charithjp/Precharger/README.md

# Precharger

This project will be a simple DC bus precharger for a 60V DC bus, controlled by an Arduino Nano. Detailed specs to follow.
