charithjp/Precharger/Precharger-KiCAD/BOM/Precharger.xlsx

Source: | C:\git\Precharger\Precharger-KiCAD\Precharger.sch
Date: | 2019-12-08 16:40
Tool: | Eeschema (5.1.2)-2
Generator: | C:\Program Files\KiCad\bin\scripting\plugins/bom_csv_grouped_by_value_with_fp.py
Component Count: | 61
Ref | Qnty | Value | Cmp name | Digikey PN | Order Description | Order QTY | Order Lines | Description | Footprint | Vendor
A1, | 1 | Arduino_Nano_v3.x | Arduino_Nano_v3.x | 1050-ABX00028-ND | Arduino Nano Every | 1 | 1,1050-ABX00028-ND,Arduino Nano Every | Arduino Nano v3.x | Module:Arduino_Nano
C2, C1, | 2 | 2.2uF 100V | C | 478-12481-1-ND | 5V input capacitor | 10 | 10,478-12481-1-ND,5V input capacitor | 2.2µF ±10% 100V Ceramic Capacitor X7R 1206 (3216 Metric) | Capacitor_SMD:C_1210_3225Metric_Pad1.42x2.65mm_HandSolder
C3, C4, | 2 | 10uF | C | 1276-6455-1-ND | 10uF 16V 0805 MLCC | 10 | 10,1276-6455-1-ND,10uF 16V 0805 MLCC | 10µF ±10% 16V Ceramic Capacitor X5R 0805 (2012 Metric) | Capacitor_SMD:C_0805_2012Metric_Pad1.15x1.40mm_HandSolder
C5, C6, | 2 | 100nF | C | 1276-2450-1-ND | 100nF 50V 0805 MLCC | 10 | 10,1276-2450-1-ND,100nF 50V 0805 MLCC | 0.1µF ±20% 50V Ceramic Capacitor X7R 0805 (2012 Metric) | Capacitor_SMD:C_0805_2012Metric_Pad1.15x1.40mm_HandSolder
C7, | 1 | 22uF | C | 399-16572-ND | 12V input capacitor | 2 | 2,399-16572-ND,12V input capacitor | 22µF 100V Aluminum Polymer Capacitor Radial, Can 45mOhm 2000 Hrs @ 125°C | Capacitor_THT:CP_Radial_D10.0mm_P5.00mm
D1, | 1 | ASMB-MTB1-0A3A2 | ASMB-MTB1-0A3A2 | 516-3280-1-ND | RGB LED | 2 | 2,516-3280-1-ND,RGB LED | Red, Green, Blue (RGB) 625nm Red, 530nm Green, 470nm Blue LED Indication - Discrete 2.1V Red, 3.1V Green, 3.1V Blue 4-PLCC | LED_SMD:LED_Avago_PLCC4_3.2x2.8mm_CW
F1, | 1 | Polyfuse | Polyfuse | 507-1349-ND | 5V input fuse | 2 | 2,507-1349-ND,5V input fuse | Polymeric PTC Resettable Fuse 240V 80mA Ih Through Hole Radial, Disc | Fuse:Fuse_BelFuse_0ZRE0008FF_L8.3mm_W3.8mm
F2, | 1 | Fuse | Fuse | 486-1173-ND | Fuseholder Clip | 4 | 4,486-1173-ND,Fuseholder Clip | Fuse Clip 10A 1 Circuit Cartridge Through Hole | General_Library:Fuseholder_Clip-5x20mm_Schurter_0751_0052_Horizontal_Open
 |  |  |  | 486-2023-ND | Fuse cover | 2 | 2,486-2023-ND,Fuse cover | FUSEHOLDER COVER FOR 1.6W
 |  |  |  | 486-1820-ND | Fuse | 5 | 5,486-1820-ND,Fuse | 5A 250V AC 125V DC Fuse Cartridge, Ceramic Holder 5mm x 20mm
J1, | 1 | Screw_Terminal_01x04 | Screw_Terminal_01x04 | 609-4979-ND | 1x4 Wire to Board | 2 | 2,609-4979-ND,1x4 Wire to Board | 4 Position Wire to Board Terminal Block Horizontal with Board 0.138" (3.50mm) Through Hole | TerminalBlock_Phoenix:TerminalBlock_Phoenix_PT-1,5-4-3.5-H_1x04_P3.50mm_Horizontal
J2, J3, J5, | 3 | Anderson_PP45_Power_RA | Anderson_PP45_Power_RA | Not available at Digikey |  |  |  | Anderson Powerpole PP45 Power Connection - RA Bottom Row | Anderson_Powerpole:Anderson_Powerpole-45A-RA-Bottom-Pair
JP2, JP1, | 2 | SolderJumper_2_Open | SolderJumper_2_Open | N/A |  |  |  | Solder Jumper, 2-pole, open | Jumper:SolderJumper-2_P1.3mm_Open_RoundedPad1.0x1.5mm
JP4, JP3, JP8, JP7, JP6, JP5, JP9, JP10, | 8 | SolderJumper_2_Bridged | SolderJumper_2_Bridged | N/A |  |  |  | Solder Jumper, 2-pole, closed/bridged | Jumper:SolderJumper-2_P1.3mm_Bridged2Bar_RoundedPad1.0x1.5mm
L1, | 1 | 68uH | L | 587-2432-1-ND | 5V input filter inductor | 2 | 2,587-2432-1-ND,5V input filter inductor | 68µH Unshielded Wirewound Inductor 190mA 1Ohm 1210 (3225 Metric) | Inductor_SMD:L_1210_3225Metric_Pad1.42x2.65mm_HandSolder
M1, M2, M3, | 3 | Anderson_PP45_Staple_Nx2 | Anderson_PP45_Staple_Nx2 | Not available at Digikey |  |  |  |  | Anderson_Powerpole:Anderson_Powerpole-staple-Nx2
PS1, | 1 | Delta_E48SC12010NRFA | Delta_E48SC12010NRFA | 941-1766-ND | 12V DCDC | 1 | 1,941-1766-ND,12V DCDC | Isolated Module DC DC Converter 1 Output 12V 10A 36V - 75V Input
Q1, | 1 | SQJQ480E | SQJQ480E | SQJQ480E-T1_GE3CT-ND | Close switch | 2 | 2,SQJQ480E-T1_GE3CT-ND,Close switch | N-Channel 80V 150A (Tc) 136W (Tc) Surface Mount PowerPAK® 8 x 8
Q2, | 1 | BSS123 | BSS123 | BSS123LT1GOSCT-ND | 12V Ena FET | 5 | 5,BSS123LT1GOSCT-ND,12V Ena FET | N-Channel 100V 170mA (Ta) 225mW (Ta) Surface Mount SOT-23-3 (TO-236)
R2, R1, R5, R4, | 4 | 22M | R | RMCF0805FT22M0CT-ND | Divider R 22M | 10 | 10,RMCF0805FT22M0CT-ND,Divider R 22M | 22 MOhms ±1% 0.125W, 1/8W Chip Resistor 0805 (2012 Metric) Automotive AEC-Q200 Thick Film
R3, R6, | 2 | 3.3M | R | RMCF0805FT3M30CT-ND | Divider R 3.3M | 5 | 5,RMCF0805FT3M30CT-ND,Divider R 3.3M | 3.3 MOhms ±1% 0.125W, 1/8W Chip Resistor 0805 (2012 Metric) Automotive AEC-Q200 Thick Film
R8, R7, | 2 | 470R 5W | R | A131375CT-ND | Precharge resistor | 4 | 4,A131375CT-ND,Precharge resistor | 470 Ohms ±5% 5W Through Hole Resistor Axial Flame Retardant Coating, Pulse Withstanding, Safety Wirewound
R10, R9, | 2 | 330R | R | In Kit |  |  |  | Resistor | Resistor_SMD:R_0805_2012Metric_Pad1.15x1.40mm_HandSolder
R11, | 1 | 150R | R | In Kit |  |  |  | Resistor | Resistor_SMD:R_0805_2012Metric_Pad1.15x1.40mm_HandSolder
R12, R13, | 2 | 100R | R | In Kit |  |  |  | Resistor | Resistor_SMD:R_0805_2012Metric_Pad1.15x1.40mm_HandSolder
R14, R15, | 2 | TRIM_UP | R | N/A |  |  |  | Resistor | Resistor_SMD:R_0805_2012Metric_Pad1.15x1.40mm_HandSolder
TP4, TP3, TP2, TP1, TP6, TP7, TP8, TP5, | 8 | TestPoint | TestPoint | N/A |  |  |  | test point | TestPoint:TestPoint_Keystone_5010-5014_Multipurpose
U1, U2, | 2 | MCP6001-OT | MCP6001-OT | MCP6001T-I/OTCT-ND | Opamp | 10 | 10,MCP6001T-I/OTCT-ND,Opamp | General Purpose Amplifier 1 Circuit Rail-to-Rail SOT-23-5
U3, | 1 | R-78HE5.0-0.3 | R-78HB5.0-0.5 | 945-3461-ND | 5V DCDC | 2 | 2,945-3461-ND,5V DCDC | Non-Isolated PoL Module DC DC Converter 1 Output 5V 300mA 6.5V - 72V Input
U4, | 1 | CPC1004N | CPC1004N | CLA154-ND | Precharge Optorelay | 2 | 2,CLA154-ND,Precharge Optorelay | Solid State SPST-NO (1 Form A) 4-SOP (0.150", 3.81mm)
U5, | 1 | VOM1271 | VOM1271 | VOM1271TCT-ND | Close driver | 2 | 2,VOM1271TCT-ND,Close driver | Optoisolator Photovoltaic Output 4500Vrms 1 Channel 4-SOP (2.54mm)
U6, | 1 | ISO7321C | ISO7321C | 296-42102-1-ND | 1/1 Isolator | 2 | 2,296-42102-1-ND,1/1 Isolator | General Purpose Digital Isolator 3000Vrms 2 Channel 25Mbps 25kV/µs CMTI 8-SOIC (0.154", 3.90mm Width)
 |  |  |  |  |  |  |  |  | 0
