charithjp/Precharger/Precharger-v2-KiCAD/Precharger.kicad_pcb

## KiCad design Precharger-v2-KiCAD/Precharger.kicad_pcb (2019-12-08)

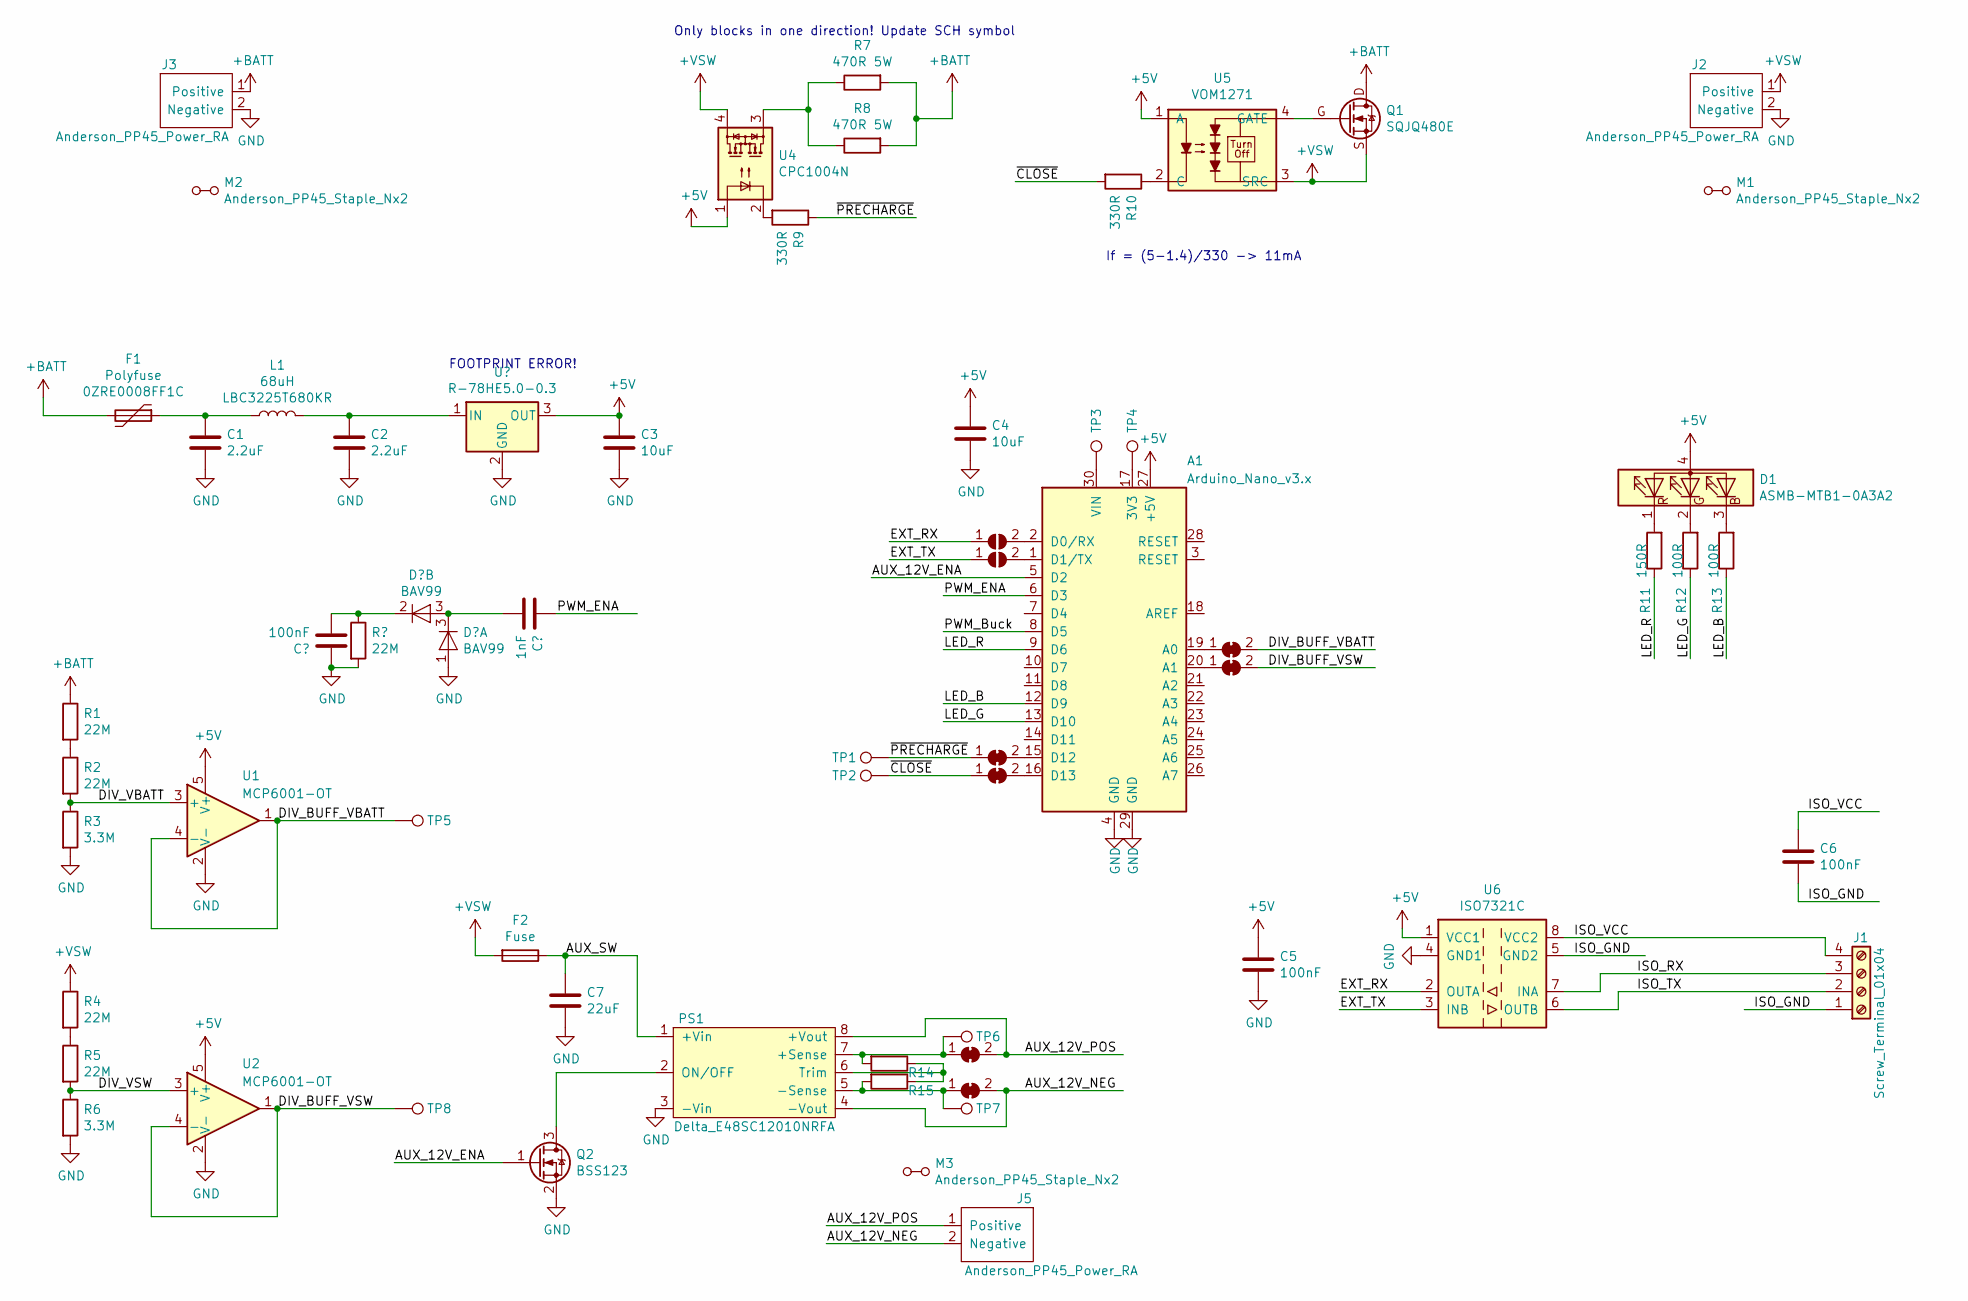
[picture p1: schematic Precharger.sch]

Parts:
A1: Arduino_Nano_v3.x; Arduino_Nano
C1, C2: 2.2uF; C_1210_3225Metric_Pad1.42x2.65mm_HandSolder
C3, C4: 10uF; C_0805_2012Metric_Pad1.15x1.40mm_HandSolder
C5, C6: 100nF; C_0805_2012Metric_Pad1.15x1.40mm_HandSolder
C7: 22uF; CP_Radial_D10.0mm_P5.00mm; Digikey PN 399-16572-ND
D1: ASMB-MTB1-0A3A2; LED_Avago_PLCC4_3.2x2.8mm_CW
F1: Polyfuse; Fuse_BelFuse_0ZRE0008FF_L8.3mm_W3.8mm; MFG_PN 0ZRE0008FF1C
F2: Fuse; Fuseholder_Clip-5x20mm_Schurter_0751_0052_Horizontal_Open
J1: Screw_Terminal_01x04; TerminalBlock_Phoenix_PT-1,5-4-3.5-H_1x04_P3.50mm_Horizontal
J2, J3, J5: Anderson_PP45_Power_RA; Anderson_Powerpole-45A-RA-Bottom-Pair
JP1, JP2: SolderJumper_2_Open; SolderJumper-2_P1.3mm_Open_RoundedPad1.0x1.5mm
JP5, JP6, JP7, JP8, JP9, JP10: SolderJumper_2_Bridged; SolderJumper-2_P1.3mm_Bridged2Bar_RoundedPad1.0x1.5mm
L1: 68uH; L_1210_3225Metric_Pad1.42x2.65mm_HandSolder; MFG_PN LBC3225T680KR
M1, M2, M3: Anderson_PP45_Staple_Nx2; Anderson_Powerpole-staple-Nx2
PS1: Delta_E48SC12010NRFA; Converter_DCDC_Delta_E48SC12010_THT
Q1: SQJQ480E; Vishay_PowerPAK_8x8L_Single
Q2: BSS123; SOT-23
R1, R2, R4, R5: 22M; R_0805_2012Metric_Pad1.15x1.40mm_HandSolder
R3, R6: 3.3M; R_0805_2012Metric_Pad1.15x1.40mm_HandSolder
R7, R8: 470R 5W; R_Axial_Power_L25.0mm_W9.0mm_P30.48mm
R9, R10: 330R; R_0805_2012Metric_Pad1.15x1.40mm_HandSolder
R11: 150R; R_0805_2012Metric_Pad1.15x1.40mm_HandSolder
R12, R13: 100R; R_0805_2012Metric_Pad1.15x1.40mm_HandSolder
R14, R15: TRIM_UP; R_0805_2012Metric_Pad1.15x1.40mm_HandSolder
TP1, TP2, TP3, TP4, TP5, TP6, TP7, TP8: TestPoint; TestPoint_Keystone_5010-5014_Multipurpose
U1, U2: MCP6001-OT; SOT-23-5_HandSoldering
U4: CPC1004N; SOP-4_3.8x4.1mm_P2.54mm_CPC1004N
U5: VOM1271; SOP-4_4.57x4.92mm_P2.54mm_VOM1271
U6: ISO7321C; SOIC-8_3.9x4.9mm_P1.27mm

Connections:
+5V: A1.27 (+5V), C3.1, C4.1, C5.1, D1.4 (A), U1.5 (V+), U2.5 (V+), U4.1, U5.1 (A), U6.1 (VCC1); also elsewhere on the board
+BATT: F1.2, J3.1 (Positive), Q1.D (Drain), R1.1, R7.2, R8.2
+VSW: F2.2, J2.1 (Positive), Q1.S (Source), R4.1, U4.4, U5.3 (SRC)
/AUX_12V_ENA: A1.5 (D2), Q2.1 (G)
/AUX_12V_NEG: J5.2 (Negative), JP10.2 (B), PS1.4 (-Vout)
/AUX_12V_POS: J5.1 (Positive), JP9.2 (B), PS1.8 (+Vout)
/AUX_SW: C7.1, F2.1, PS1.1 (+Vin)
/DIV_BUFF_VBATT: JP7.2 (B), TP5.1, U1.1, U1.4 (-)
/DIV_BUFF_VSW: JP8.2 (B), TP8.1, U2.1, U2.4 (-)
/DIV_VBATT: R2.2, R3.1, U1.3 (+)
/DIV_VSW: R5.2, R6.1, U2.3 (+)
/EXT_RX: JP1.1 (A), U6.2 (OUTA); also elsewhere on the board
/EXT_TX: JP2.1 (A), U6.3 (INB); also elsewhere on the board
/ISO_GND: C6.2, J1.1, U6.5 (GND2)
/ISO_RX: J1.3, U6.7 (INA)
/ISO_TX: J1.2, U6.6 (OUTB)
/ISO_VCC: C6.1, J1.4, U6.8 (VCC2)
/LED_B: A1.12 (D9), R13.1
/LED_G: A1.13 (D10), R12.1
/LED_R: A1.9 (D6), A1.14 (D11), R11.1
/~CLOSE: JP6.1 (A), R10.2, TP2.1
/~PRECHARGE: JP5.1 (A), R9.1, TP1.1
GND: A1.4 (GND), A1.29 (GND), C1.2, C2.2, C3.2, C4.2, C5.2, C7.2, J2.2 (Negative), J3.2 (Negative), PS1.3 (-Vin), Q2.2 (S), R3.2, R6.2, U1.2 (V-), U2.2 (V-), U6.4 (GND1); also elsewhere on the board
unnamed: A1.1 (D1/TX), JP2.2 (B)
unnamed: A1.2 (D0/RX), JP1.2 (B)
unnamed 25: A1.7 (D4); also elsewhere on the board
unnamed 26: A1.8 (D5); also elsewhere on the board
unnamed: A1.15 (D12), JP5.2 (B)
unnamed: A1.16 (D13), JP6.2 (B)
unnamed: A1.17 (3V3), TP4.1
unnamed: A1.19 (A0), JP7.1 (A)
unnamed: A1.20 (A1), JP8.1 (A)
unnamed: A1.30 (VIN), TP3.1
unnamed: C1.1, F1.1, L1.1
unnamed 34: C2.1, L1.2; also elsewhere on the board
unnamed: D1.1 (RK), R11.2
unnamed: D1.2 (GK), R12.2
unnamed: D1.3 (BK), R13.2
unnamed: JP9.1 (A), PS1.7 (+Sense), R14.2, TP6.1
unnamed: JP10.1 (A), PS1.5 (-Sense), R15.2, TP7.1
unnamed: PS1.2 (ON/OFF), Q2.3 (D)
unnamed: PS1.6 (Trim), R14.1, R15.1
unnamed: Q1.G (Gate), U5.4 (GATE)
unnamed: R1.2, R2.1
unnamed: R4.2, R5.1
unnamed: R7.1, R8.1, U4.3
unnamed: R9.2, U4.2
unnamed: R10.1, U5.2 (C)

Notes on the sheet:
If = (5-1.4)/330 -> 11mA
FOOTPRINT ERROR!
Only blocks in one direction! Update SCH symbol

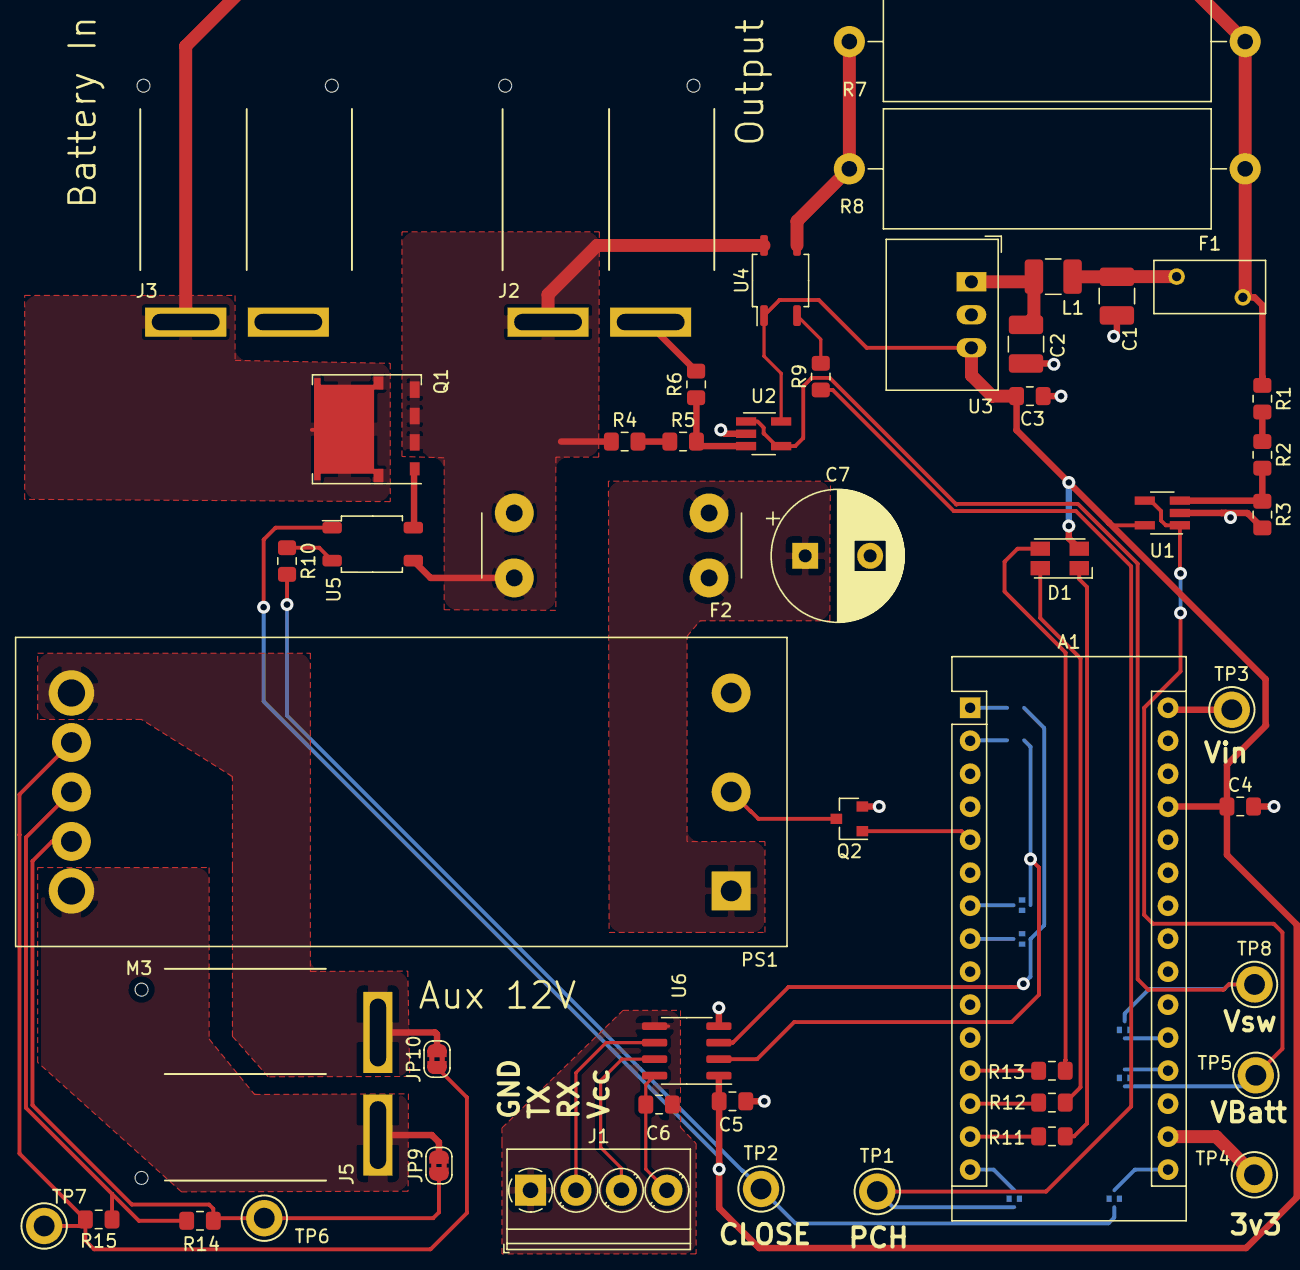
[picture p2: board Precharger.kicad_pcb from above]

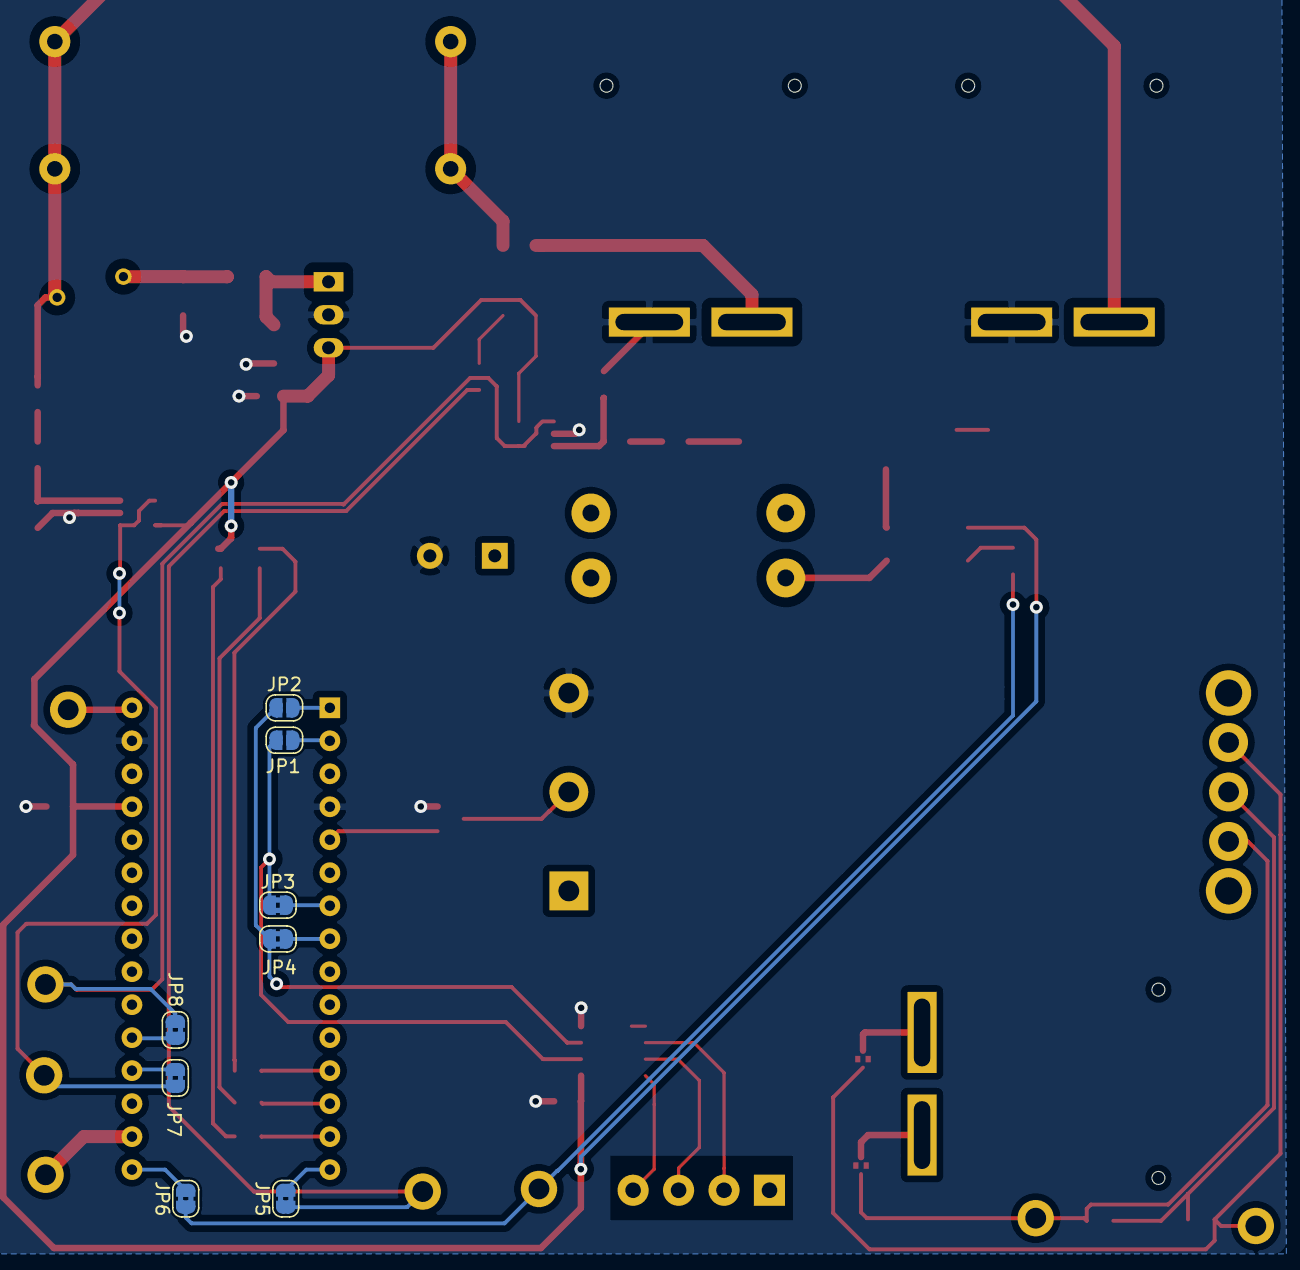
[picture p3: board Precharger.kicad_pcb from below]

Board: 2 copper layers, 61 parts (8 on the bottom side), 48 nets.

Other parts of the board:
JP3, JP4: SolderJumper_2_Bridged; SolderJumper-2_P1.3mm_Bridged2Bar_RoundedPad1.0x1.5mm
U3: R-78HE5.0-0.3; Converter_DCDC_RECOM_R-78HB-0.5_THT

Their connections:
+5V: U3.3; also elsewhere on the board
/EXT_RX: JP3.1; also elsewhere on the board
/EXT_TX: JP4.1; also elsewhere on the board
GND: U3.2; also elsewhere on the board
unnamed 25: JP3.2; also elsewhere on the board
unnamed 26: JP4.2; also elsewhere on the board
unnamed 34: U3.1; also elsewhere on the board
