charithjp/Precharger/(commit log)

2019-12-02 Adding precharger library and update to precharger schematics
    [Precharger.sch]
2019-12-03 Making a start on the PCB
    [Precharger.sch]
2019-12-07 Close to finishing up schematic
    [Precharger.kicad_pcb, Precharger.sch]
2019-12-08 Finished routing and generated fab outputs
    [Precharger-B_Cu.gbl, Precharger-B_Mask.gbs, Precharger-B_Paste.gbp, Precharger-B_SilkS.gbo, Precharger-F_Cu.gtl, Precharger-F_Mask.gts, Precharger-F_Paste.gtp, Precharger-F_SilkS.gto]
2019-12-09 Changing dividing resistors down due to reasonably cheap values in 1% tolerence and adding BOM excel file for Digikey Ordering
    [Precharger.sch, Precharger.xlsx]
2019-12-20 Updating errors
    [Precharger.sch]
2019-12-21 Working on arduino code
    [Precharger.sch]
2019-12-25 Changed to unsigned printing - still has a slight issue where it starts with the close fet asserted :(
    [Sketch.ino]
2019-12-26 Getting a v2 going to try a buck precharge stage
    [Precharger.kicad_pcb, Precharger.sch]
2019-12-26 Converted v2 to multi sheet schematics
    [5V_Supply.sch, Aux_12V.sch, Iso_Communication.sch, Power_Precharge.sch, Precharger.sch, Voltage_Sensing.sch]
2020-01-11 Starting update with negative switching
    [5V_Supply.sch, Power_Supply.sch, Precharger.sch, Voltage_Sensing.sch]
2020-01-11 Adding comment for inductor
    [Power_Precharge.sch]
